GV-ing/SpiderBot/Spider_Docs/SpiderBot.jpeg

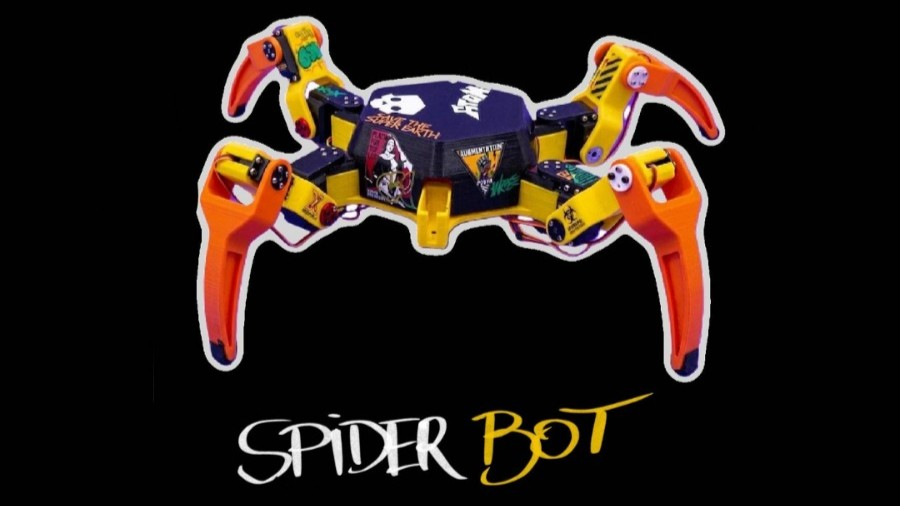
Spider_Docs/SpiderBot.jpeg
