GV-ing/SpiderBot/MatLab/STL/Leg_C.stl

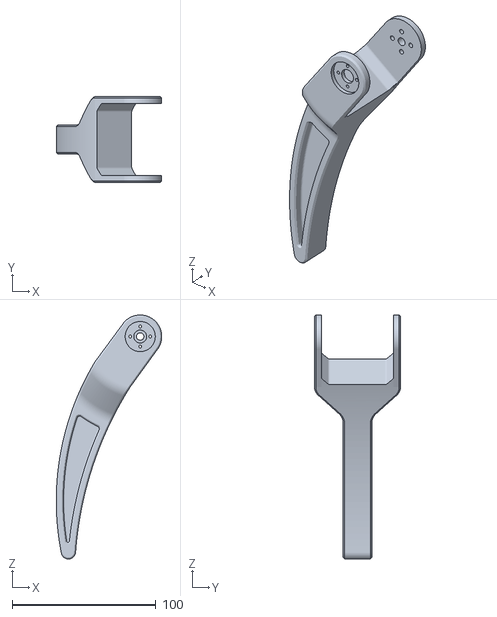
[picture p42: CAD file, 2026-06-25]
MatLab/STL/Leg_C.stl
73.5 x 60.0 x 169.9
