GV-ing/SpiderBot/MuJoCo-Jax/models/Body.stl

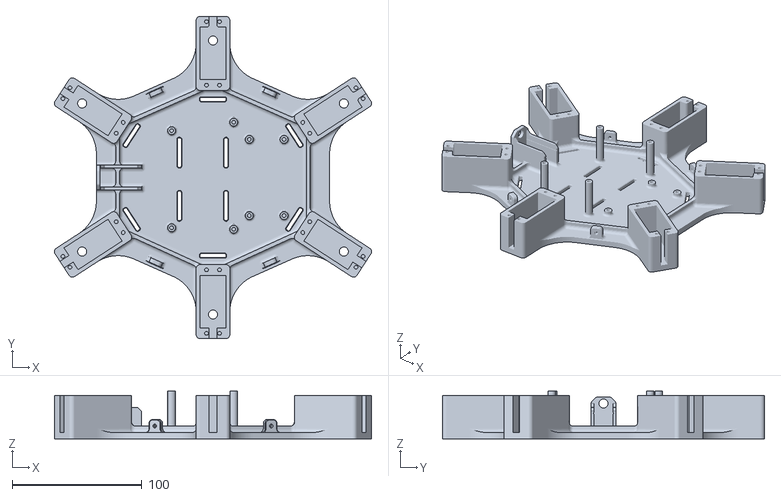
[picture p43: CAD file, 2026-06-25]
MuJoCo-Jax/models/Body.stl
244.8 x 248.4 x 37.0
