GV-ing/SpiderBot/spiderbot_urdf/models/Leg_A.stl

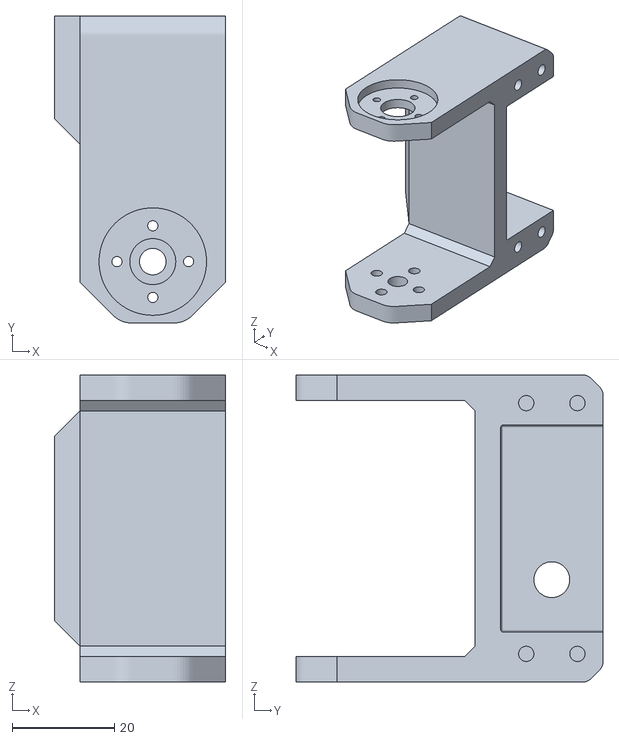
[picture p44: CAD file, 2026-06-25]
spiderbot_urdf/models/Leg_A.stl
33.5 x 60.0 x 60.0
