GV-ing/SpiderBot/MatLab/STL/Leg_B.stl

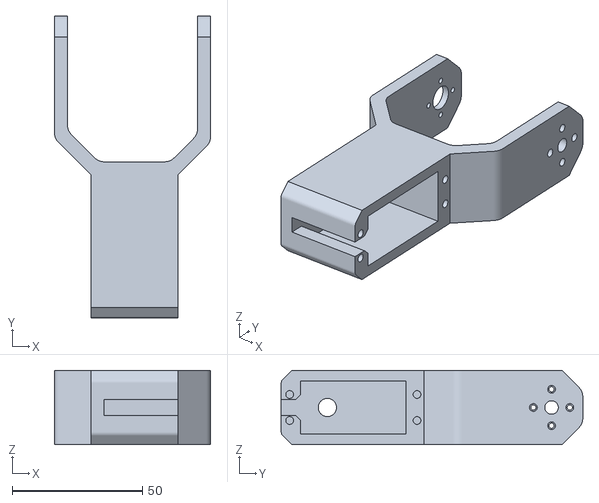
[picture p45: CAD file, 2026-06-25]
MatLab/STL/Leg_B.stl
60.0 x 116.0 x 28.5
