GV-ing/SpiderBot/spiderbot_urdf/models/Upper_Body.stl

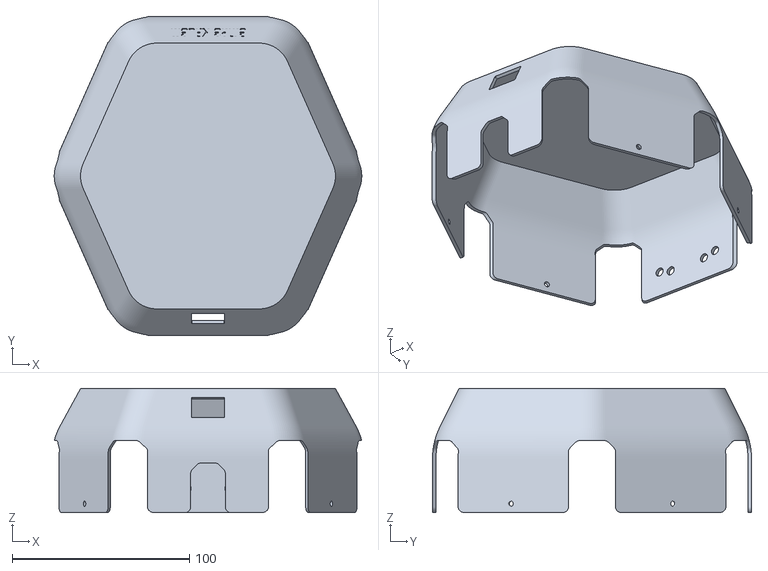
[picture p46: CAD file, 2026-06-25]
spiderbot_urdf/models/Upper_Body.stl
173.5 x 180.0 x 70.0
