GV-ing/SpiderBot/Mujoco-Jax-TEL/Tracking_Vx.pdf

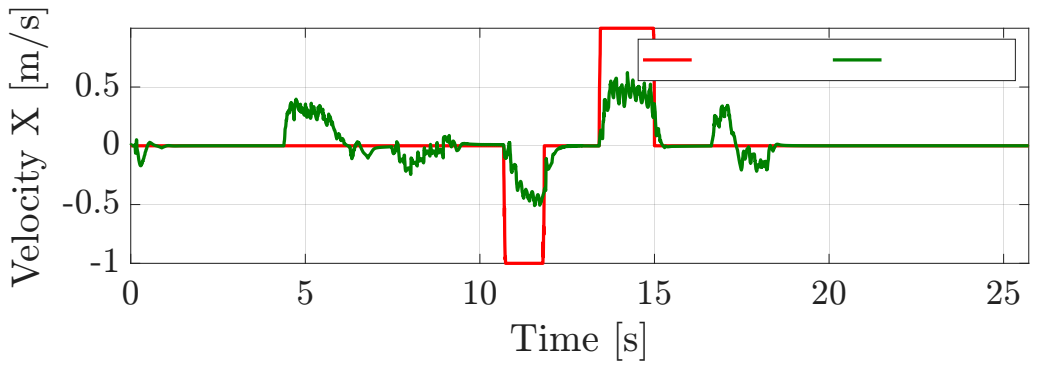
[picture p47: page 1]
Velocity X [m/s]
