GV-ing/SpiderBot/Mujoco-Jax-TEL/Tracking_Vy.pdf

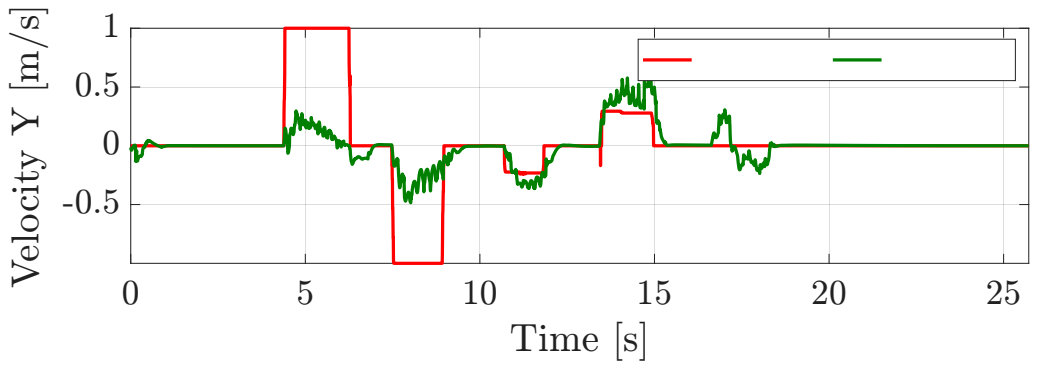
[picture p48: page 1]
Velocity Y [m/s]
