GV-ing/SpiderBot/Mujoco-Jax-TEL/Tracking_Yaw.pdf

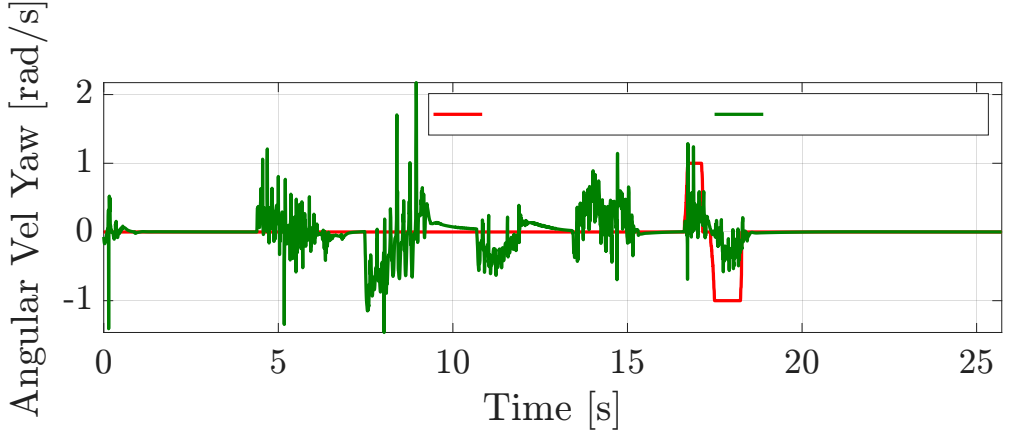
[picture p49: page 1]

Angular Vel Yaw [rad/s]
