GV-ing/SpiderBot/Spider_Docs/Graphs-OpenLoop/Velocity_Creep.pdf

0.50

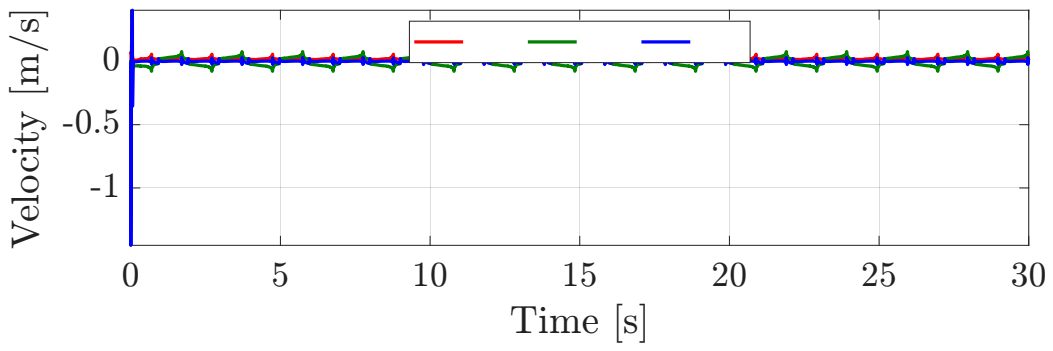
[picture p50: page 1]
Velocity m[ /s]
