GV-ing/SpiderBot/Spider_Docs/Graphs-OpenLoop/Velocity_Gallop.pdf

0.50

Velocity m[ /s]
