GV-ing/SpiderBot/Spider_Docs/Graphs-OpenLoop/Velocity_Pace.pdf

0.50 0.5

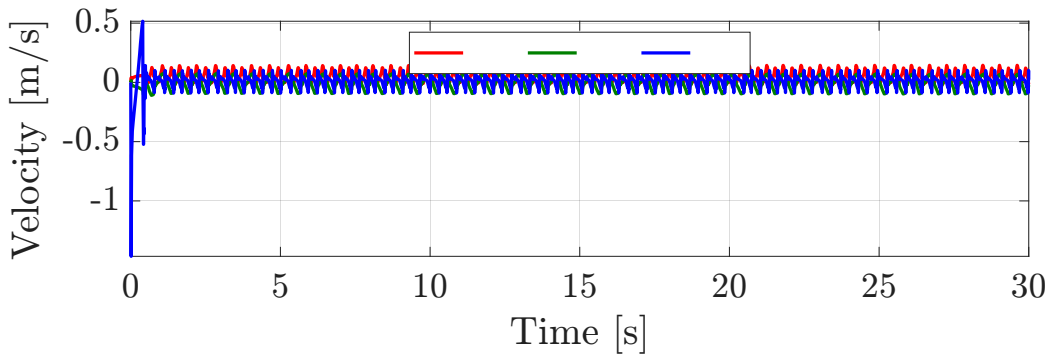
[picture p51: page 1]
Velocity m[ /s]
