GV-ing/SpiderBot/Spider_Docs/Graphs-OpenLoop/Velocity_Trot.pdf

0.50

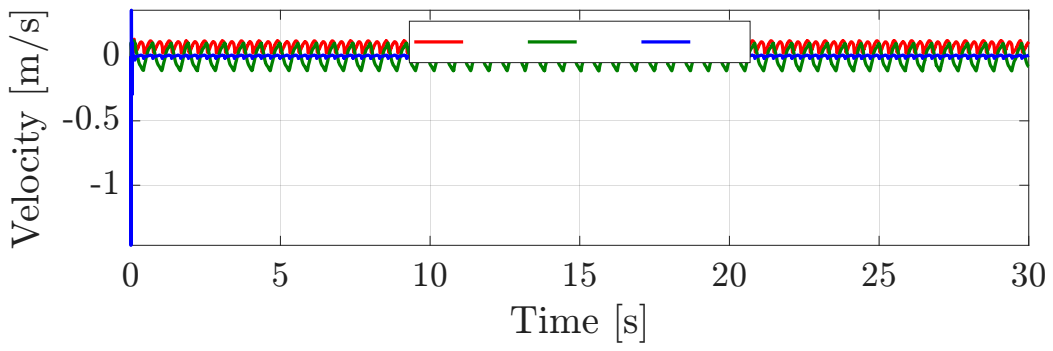
[picture p52: page 1]
Velocity m[ /s]
