GV-ing/SpiderBot/Spider_Docs/Graphs-OpenLoop/Position_Creep.pdf

0.2 0.4 0.6

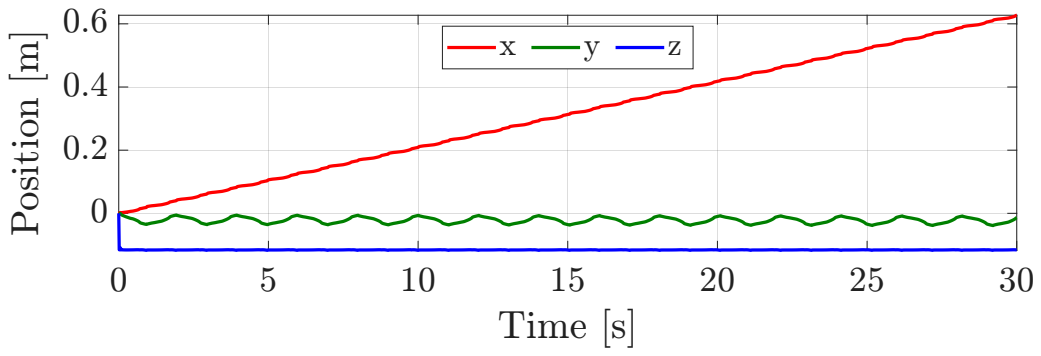
[picture p53: page 1]
Position [m]
