GV-ing/SpiderBot/Spider_Docs/Graphs-OpenLoop/Position_Gallop.pdf

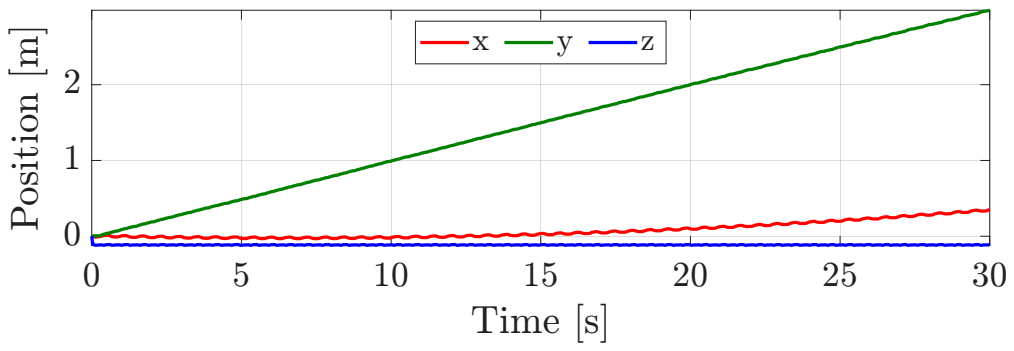
[picture p54: page 1]
Position [m]
