GV-ing/SpiderBot/Spider_Docs/Graphs-OpenLoop/Position_Pace.pdf

0.51 1.5

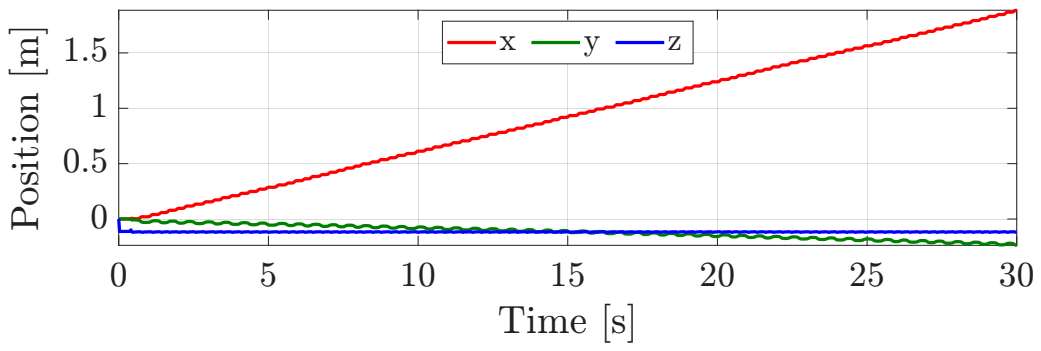
[picture p55: page 1]
Position [m]
