GV-ing/SpiderBot/Spider_Docs/Graphs-OpenLoop/Position_Trot.pdf

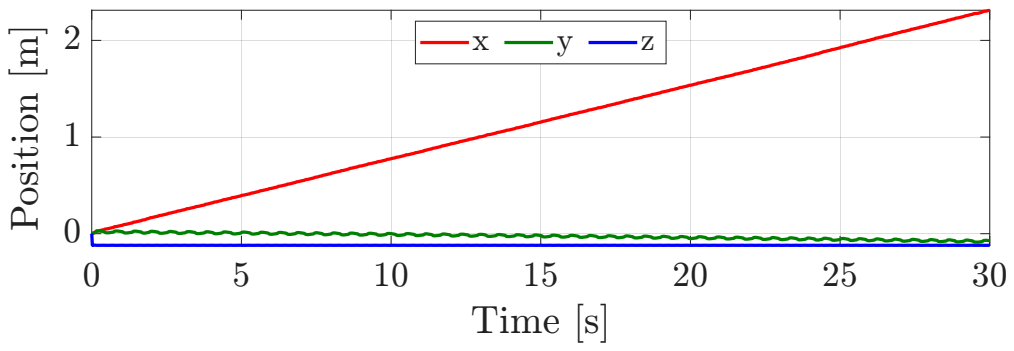
[picture p56: page 1]
Position [m]
