GV-ing/SpiderBot/Spider_Docs/Graphs-OpenLoop/Rotation_Creep.pdf

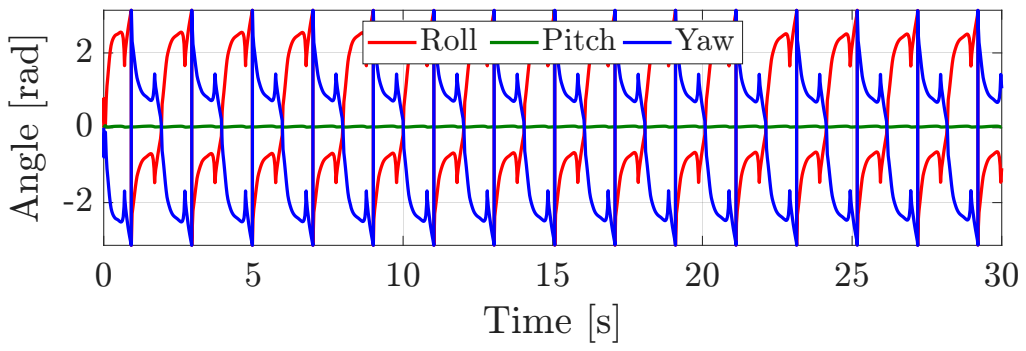
[picture p57: page 1]
Angle [rad]
