GV-ing/SpiderBot/Spider_Docs/Graphs-OpenLoop/Rotation_Gallop.pdf

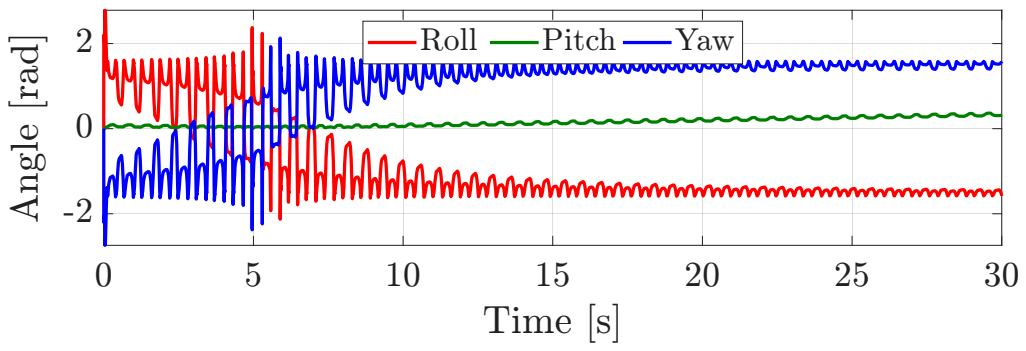
[picture p58: page 1]
Angle [rad]
