GV-ing/SpiderBot/Spider_Docs/Graphs-OpenLoop/Rotation_Pace.pdf

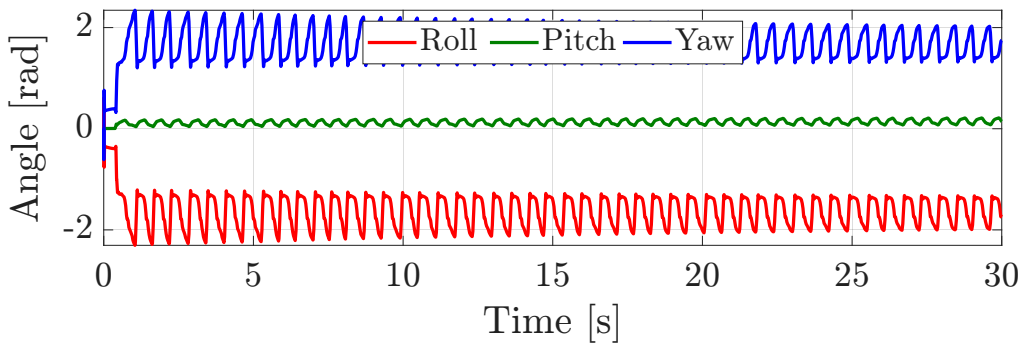
[picture p59: page 1]
Angle [rad]
