GV-ing/SpiderBot/Spider_Docs/Graphs-OpenLoop/Rotation_Trot.pdf

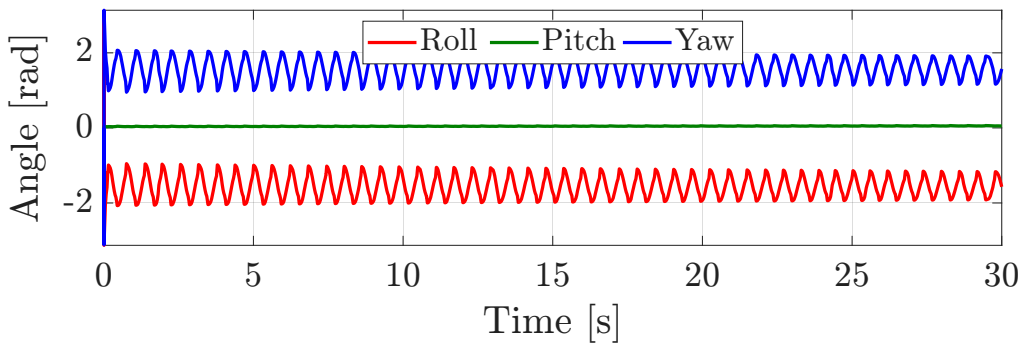
[picture p60: page 1]
Angle [rad]
